Brooks98/Senior-Design-305/README.md

# Senior-Design-305
# ControllerMainForward and VehicleMainForward are the final codes used
