Brooks98/Senior-Design-305/CAD/thumbstickV5_2_1.STL

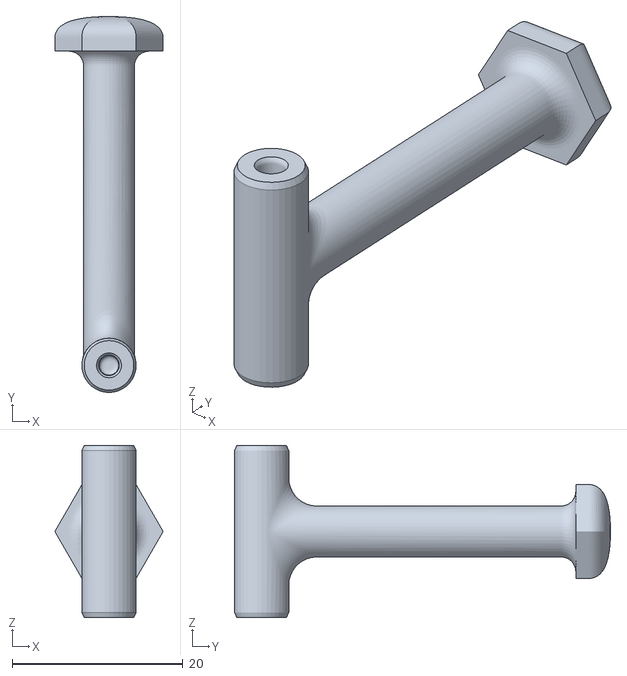
[picture p1: CAD file, 2021-04-21]
CAD/thumbstickV5_2_1.STL
12.7 x 44.1 x 20.2
