Brooks98/Senior-Design-305/CAD/Box2-BoxBottom.DXF

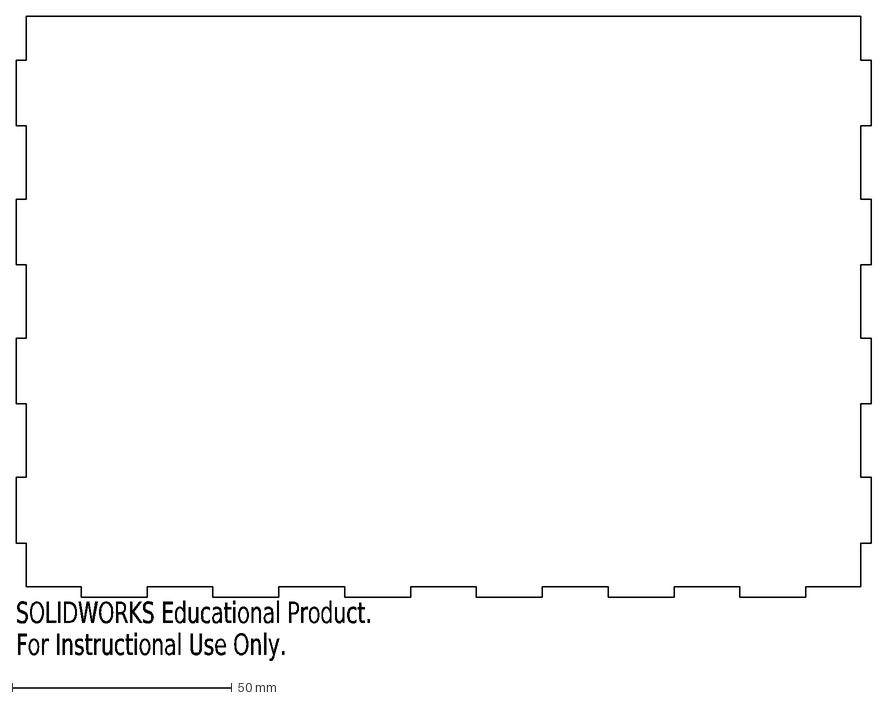
[picture p2: CAD file, 2021-04-21]
CAD/Box2-BoxBottom.DXF
SOLIDWORKS Educational Product.
For Instructional Use Only.
