Brooks98/Senior-Design-305/CAD/Box2-BoxBack.DXF

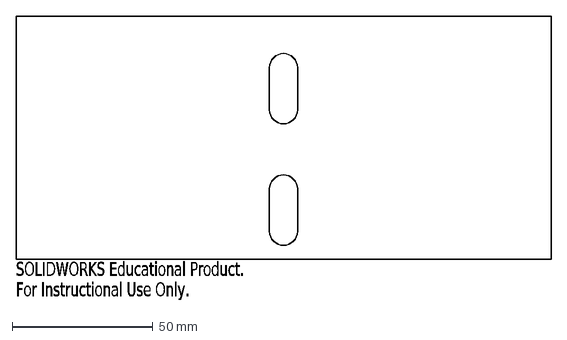
[picture p3: CAD file, 2021-04-21]
CAD/Box2-BoxBack.DXF
SOLIDWORKS Educational Product.
For Instructional Use Only.
