Brooks98/Senior-Design-305/CAD/Box2-BoxSideL.DXF

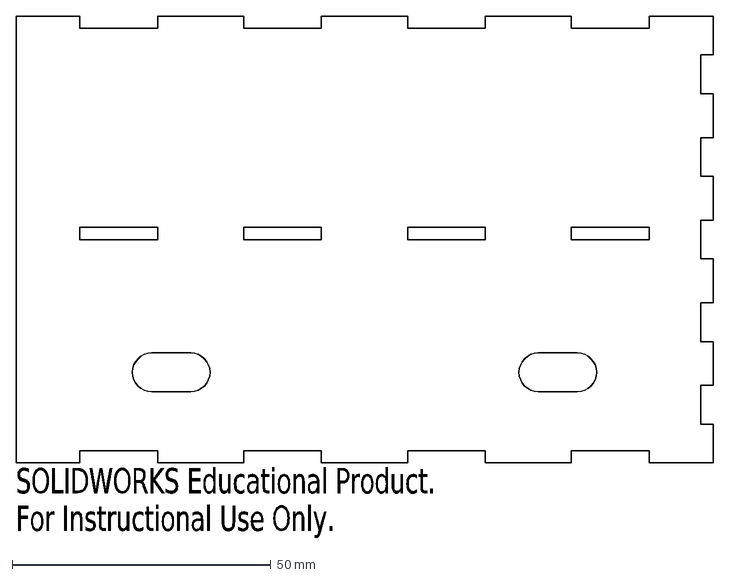
[picture p4: CAD file, 2021-04-21]
CAD/Box2-BoxSideL.DXF
SOLIDWORKS Educational Product.
For Instructional Use Only.
