Brooks98/Senior-Design-305/CAD/MotorMountV5_3_0.STL

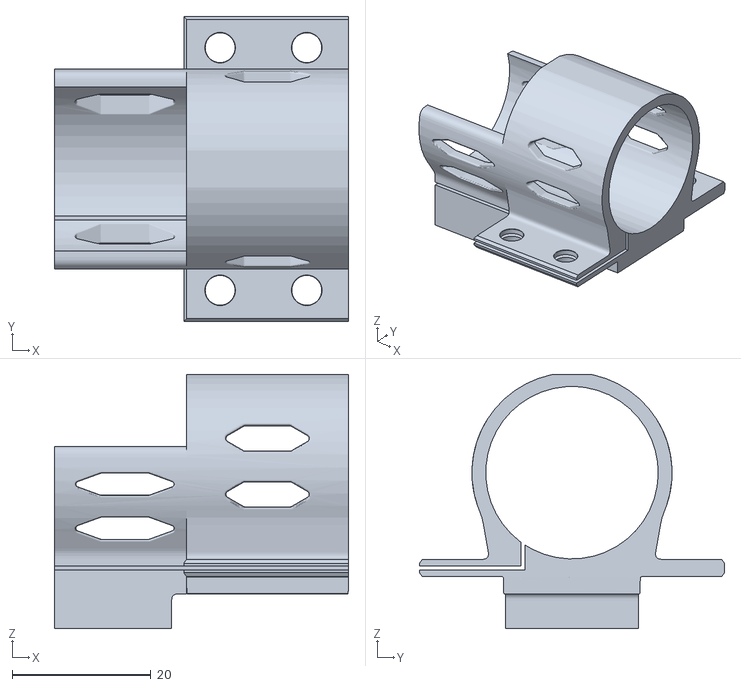
[picture p5: CAD file, 2021-04-21]
CAD/MotorMountV5_3_0.STL
42.4 x 44.0 x 36.7
