Brooks98/Senior-Design-305/CAD/Box2-BoxTop.DXF

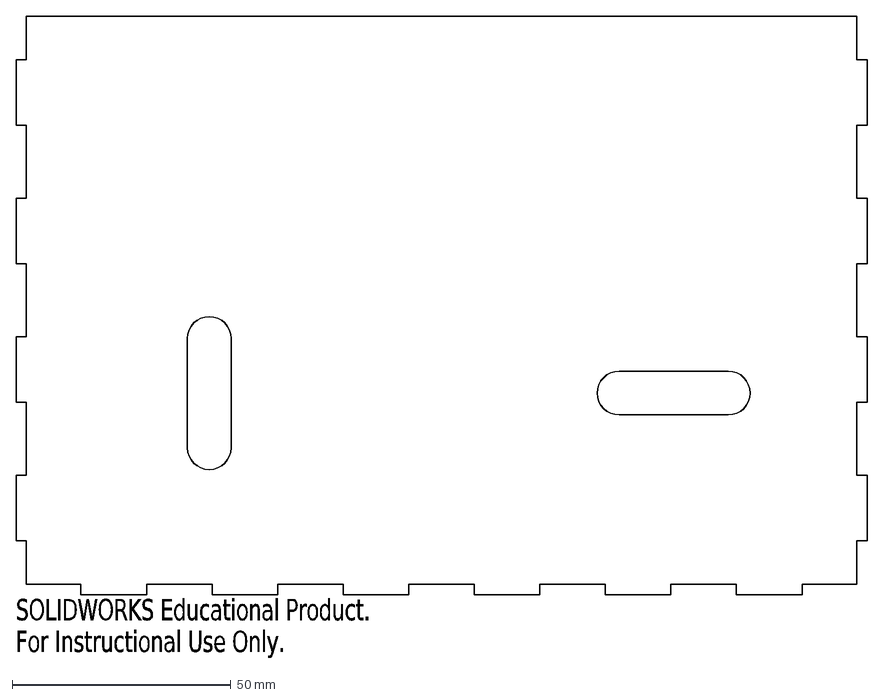
[picture p6: CAD file, 2021-04-21]
CAD/Box2-BoxTop.DXF
SOLIDWORKS Educational Product.
For Instructional Use Only.
