Brooks98/Senior-Design-305/CAD/1DGimbalBaseV5_1_2.STL

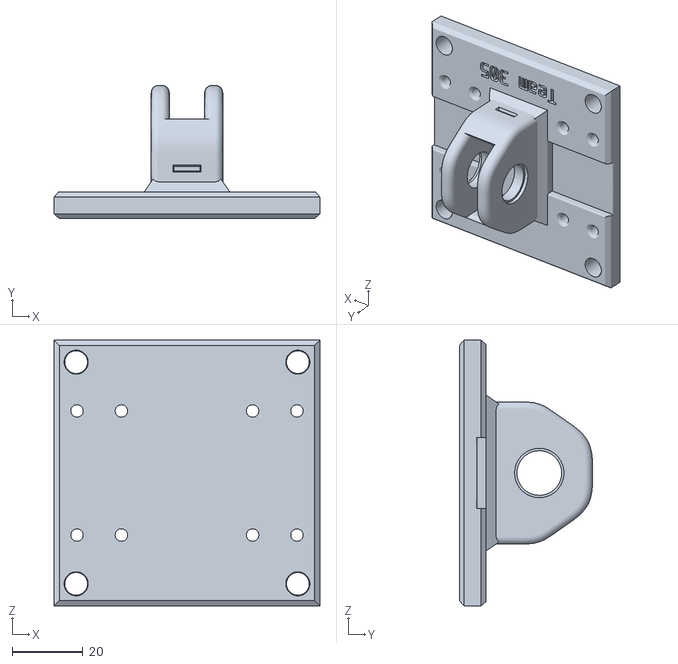
[picture p7: CAD file, 2021-04-21]
CAD/1DGimbalBaseV5_1_2.STL
75.0 x 37.5 x 75.0
