Brooks98/Senior-Design-305/CAD/Box2-BoxFront.DXF

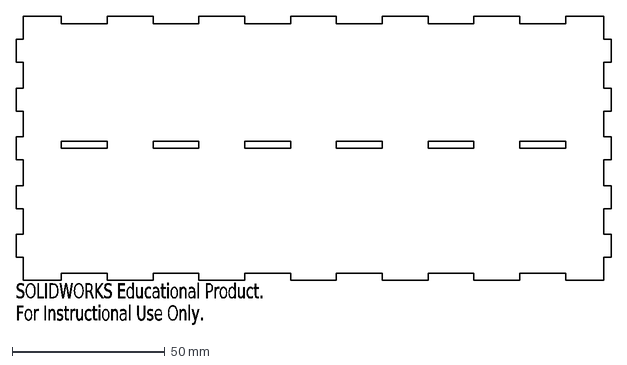
[picture p8: CAD file, 2021-04-21]
CAD/Box2-BoxFront.DXF
SOLIDWORKS Educational Product.
For Instructional Use Only.
