Brooks98/Senior-Design-305/CAD/Box2-BoxMiddle.DXF

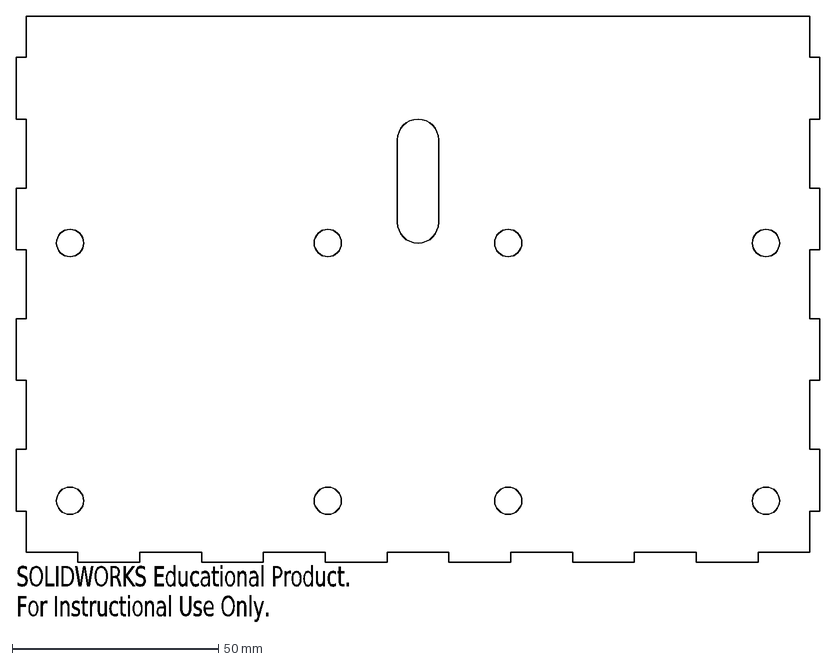
[picture p9: CAD file, 2021-04-21]
CAD/Box2-BoxMiddle.DXF
SOLIDWORKS Educational Product.
For Instructional Use Only.
