Brooks98/Senior-Design-305/CAD/Box2-BoxSideR.DXF

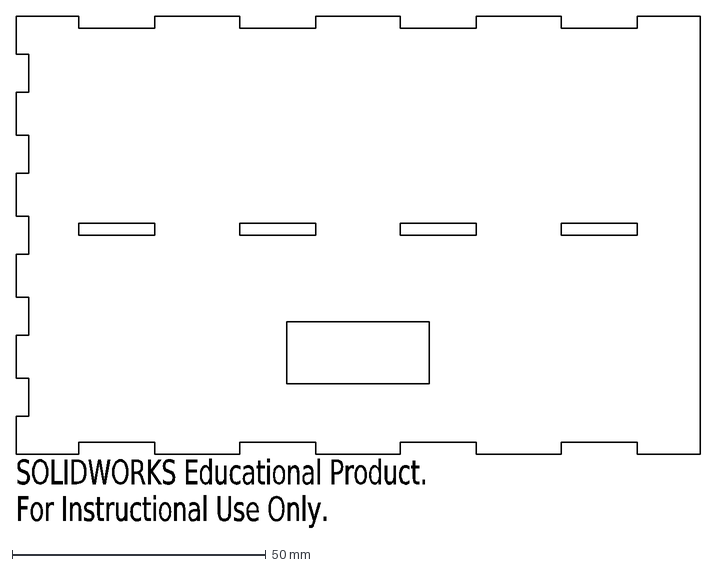
[picture p10: CAD file, 2021-04-21]
CAD/Box2-BoxSideR.DXF
SOLIDWORKS Educational Product.
For Instructional Use Only.
