Brooks98/Senior-Design-305/ControllerMainForward.ino

//Encoder *********************************
#include <Encoder.h>
#include <SPI.h>
#include <nRF24L01.h>
#include <RF24.h>

Encoder motorleft(2, 3); //(2,3)
Encoder motorright(33,34);
long positionLeft  = -999;

int in_pin1 = 20;
int in_pin2 = 19;
int enable_pinL = 37;

int in_pin3 = 17;
int in_pin4 = 16;
int enable_pinR = 18;

int forwardmax = 50;
int backwardmax = -50;
int centerleft = 0;
int currentleft;

int rightmax = -50;
int leftmax = 50;
int centerright = 0;
int currentright;
//****************************************

//Radio *********************************
RF24 radio(8, 7); // CE, CSN
const byte addresses [][6] = {"007", "001"};    //Setting the two addresses. One for transmitting and one for receiving
int distance = 0;
//***************************************

//Info to send to vehicle ******************
int data[4] = {0,0,0,0}; //data[0] = speed, data[1] = turning
int speedy; //negative is backwards, forward in positive
int turn;
//******************************************


void setup() {
//  Serial.begin(9600);
//  Serial.println("Setup");

  radio.begin();                            //Starting the radio communication
  radio.openWritingPipe(addresses[0]);      //Setting the address at which we will send the data
  radio.openReadingPipe(1, addresses[1]);   //Setting the address at which we will receive the data
  radio.setPALevel(RF24_PA_MAX);            //You can set it as minimum or maximum depending on the distance between the transmitter and receiver.
  //radio.setDataRate( RF24_250KBPS );
  //radio.setRetries(1,15); // delay, count
  //initialvalues(); //calculates center encoder value at startup
  //recenter();
  
  pinMode(enable_pinL, OUTPUT);
  pinMode(enable_pinR, OUTPUT);
  pinMode(in_pin1, OUTPUT);
  pinMode(in_pin2, OUTPUT);
  pinMode(in_pin3, OUTPUT);
  pinMode(in_pin4, OUTPUT);
 
  
}
void loop()
{ 


//  delay(100);
  // Gets encoder values **********
  int newLeft;
  newLeft = motorleft.read();
  if (newLeft != currentleft) {

    currentleft = newLeft;
  }

  int newRight;
  newRight = motorright.read();
  if(newRight != currentright)
  {
    currentright = newRight;
  }

  //*****************************

  //Calculates speed & direction ********
  //speedy = (currentleft - centerleft)* ((200)/(abs(forwardmax)+abs(backwardmax)));
  speedy = currentleft;
  data[1] = speedy;
  turn = currentright;
  data[0] = turn;
  //*************************************
 
  delay(10);// increase maybe? 
  radio.stopListening(); 
  radio.write(data, sizeof(data));
  delay(50); 
  radio.startListening();                    //This sets the module as receiver
 
  if (radio.available())                     //Looking for incoming data
  {

//    Serial.print("Left Encoder = ");
//    Serial.print(currentleft);
//    Serial.print("\tSpeedy = ");
//    Serial.print(speedy);
//    Serial.print("\tRight Encoder = ");
//    Serial.print(currentright);
//    Serial.print("\t");
    
    radio.read(&distance, sizeof(distance)); // reading in data for distance sensor
//    Serial.print("Distance: ");
//    Serial.print(distance);
//    Serial.println(" cm"); 
  }


   
//**********************************************************
 if(currentleft > (centerleft + 5) && (distance < 30))
    {
      
      int joystickspeed;
      if (distance > 3)
      {
        joystickspeed = map(distance, 0, 30, 210, 185);
      }
      else
      {
        joystickspeed = 210;
      }

      leftbackward(joystickspeed);
       
    }
    else
    {
      digitalWrite(in_pin1, LOW);
      digitalWrite(in_pin2, LOW);
      digitalWrite(in_pin3, LOW);
      digitalWrite(in_pin4, LOW);
//      recenterleft();
    }
       recenterright();
}

void initialvalues(){

  leftbackward(255);
  delay(1000);
 
  leftforward(255);
  delay(1000);
  forwardmax = motorleft.read();
  delay(300);
 
  leftbackward(255);
  delay(1000);
  backwardmax = motorleft.read();
  delay(300);

  leftstop();
 
  centerleft = (forwardmax+backwardmax)/2;
//  Serial.print("forwardmax = ");
//  Serial.print(forwardmax);
//  Serial.print("\n");
//  Serial.print("backwardmax = ");
//  Serial.print(backwardmax);
//  Serial.print("\n");
//  Serial.print("center = ");
//  Serial.print(centerleft);
//  Serial.print("\n");
}
void leftforward(int sp)
{
  analogWrite(enable_pinL, sp);
  digitalWrite(in_pin1, HIGH);
  digitalWrite(in_pin2, 0);
}
void leftbackward(int sp)
{
  analogWrite(enable_pinL, sp);
  digitalWrite(in_pin1, 0);
  digitalWrite(in_pin2, HIGH);
}
void leftstop()
{
  analogWrite(enable_pinL, 0);
  digitalWrite(in_pin1, 0);
  digitalWrite(in_pin2, 0);
}
void rightright(int sp)
{
  analogWrite(enable_pinR, sp);
  digitalWrite(in_pin3, HIGH);
  digitalWrite(in_pin4, 0);
}
void rightleft(int sp)
{
  analogWrite(enable_pinR, sp);
  digitalWrite(in_pin3, 0);
  digitalWrite(in_pin4, HIGH);
}
void rightstop()
{
  analogWrite(enable_pinR, 0);
  digitalWrite(in_pin3, 0);
  digitalWrite(in_pin4, 0);
}
void recenterleft(){
    if (currentleft < centerleft - 7)
    {
      leftforward(175);
    }
    else if (currentleft > centerleft + 7)
    {
       leftbackward(175);
    }
    else
    {
      leftstop();
    }
}
void recenterright(){
    if (currentright < centerright - 5)
    {
      int sp = constrain(currentright , -5, -40);
      sp = map(sp, -5,-40, 155, 230);
      
      rightleft(sp);

    }
    else if(currentright > centerright + 5)
    {
      int sp = constrain(currentright , 5, 40);
      sp = map(sp, 5,40, 155, 170);
      
      rightright(sp); 
    }
    else
    {
      rightstop();
    }

}
