Brooks98/Senior-Design-305/(commit log)

2021-03-05 Update and rename Gyro_raw_data.ino to Gyro_orientation_data.ino
2021-03-31 Create FilterIIR
